Srijal97/Induction-Heating-ATmega128/README.md

# Induction-Heating-ATmega128
Code and other files for the control of Induction Heating of metals for temperatures up to 1200C+ for Riddhi Heatron. Control board uses the ATmega128 microcontroller.
