Srijal97/Induction-Heating-ATmega128/PCB/2018-SPIT-IH-Ver4-Atmeha-final1.brd

## EAGLE design PCB/2018-SPIT-IH-Ver4-Atmeha-final1.brd (2019-11-06)

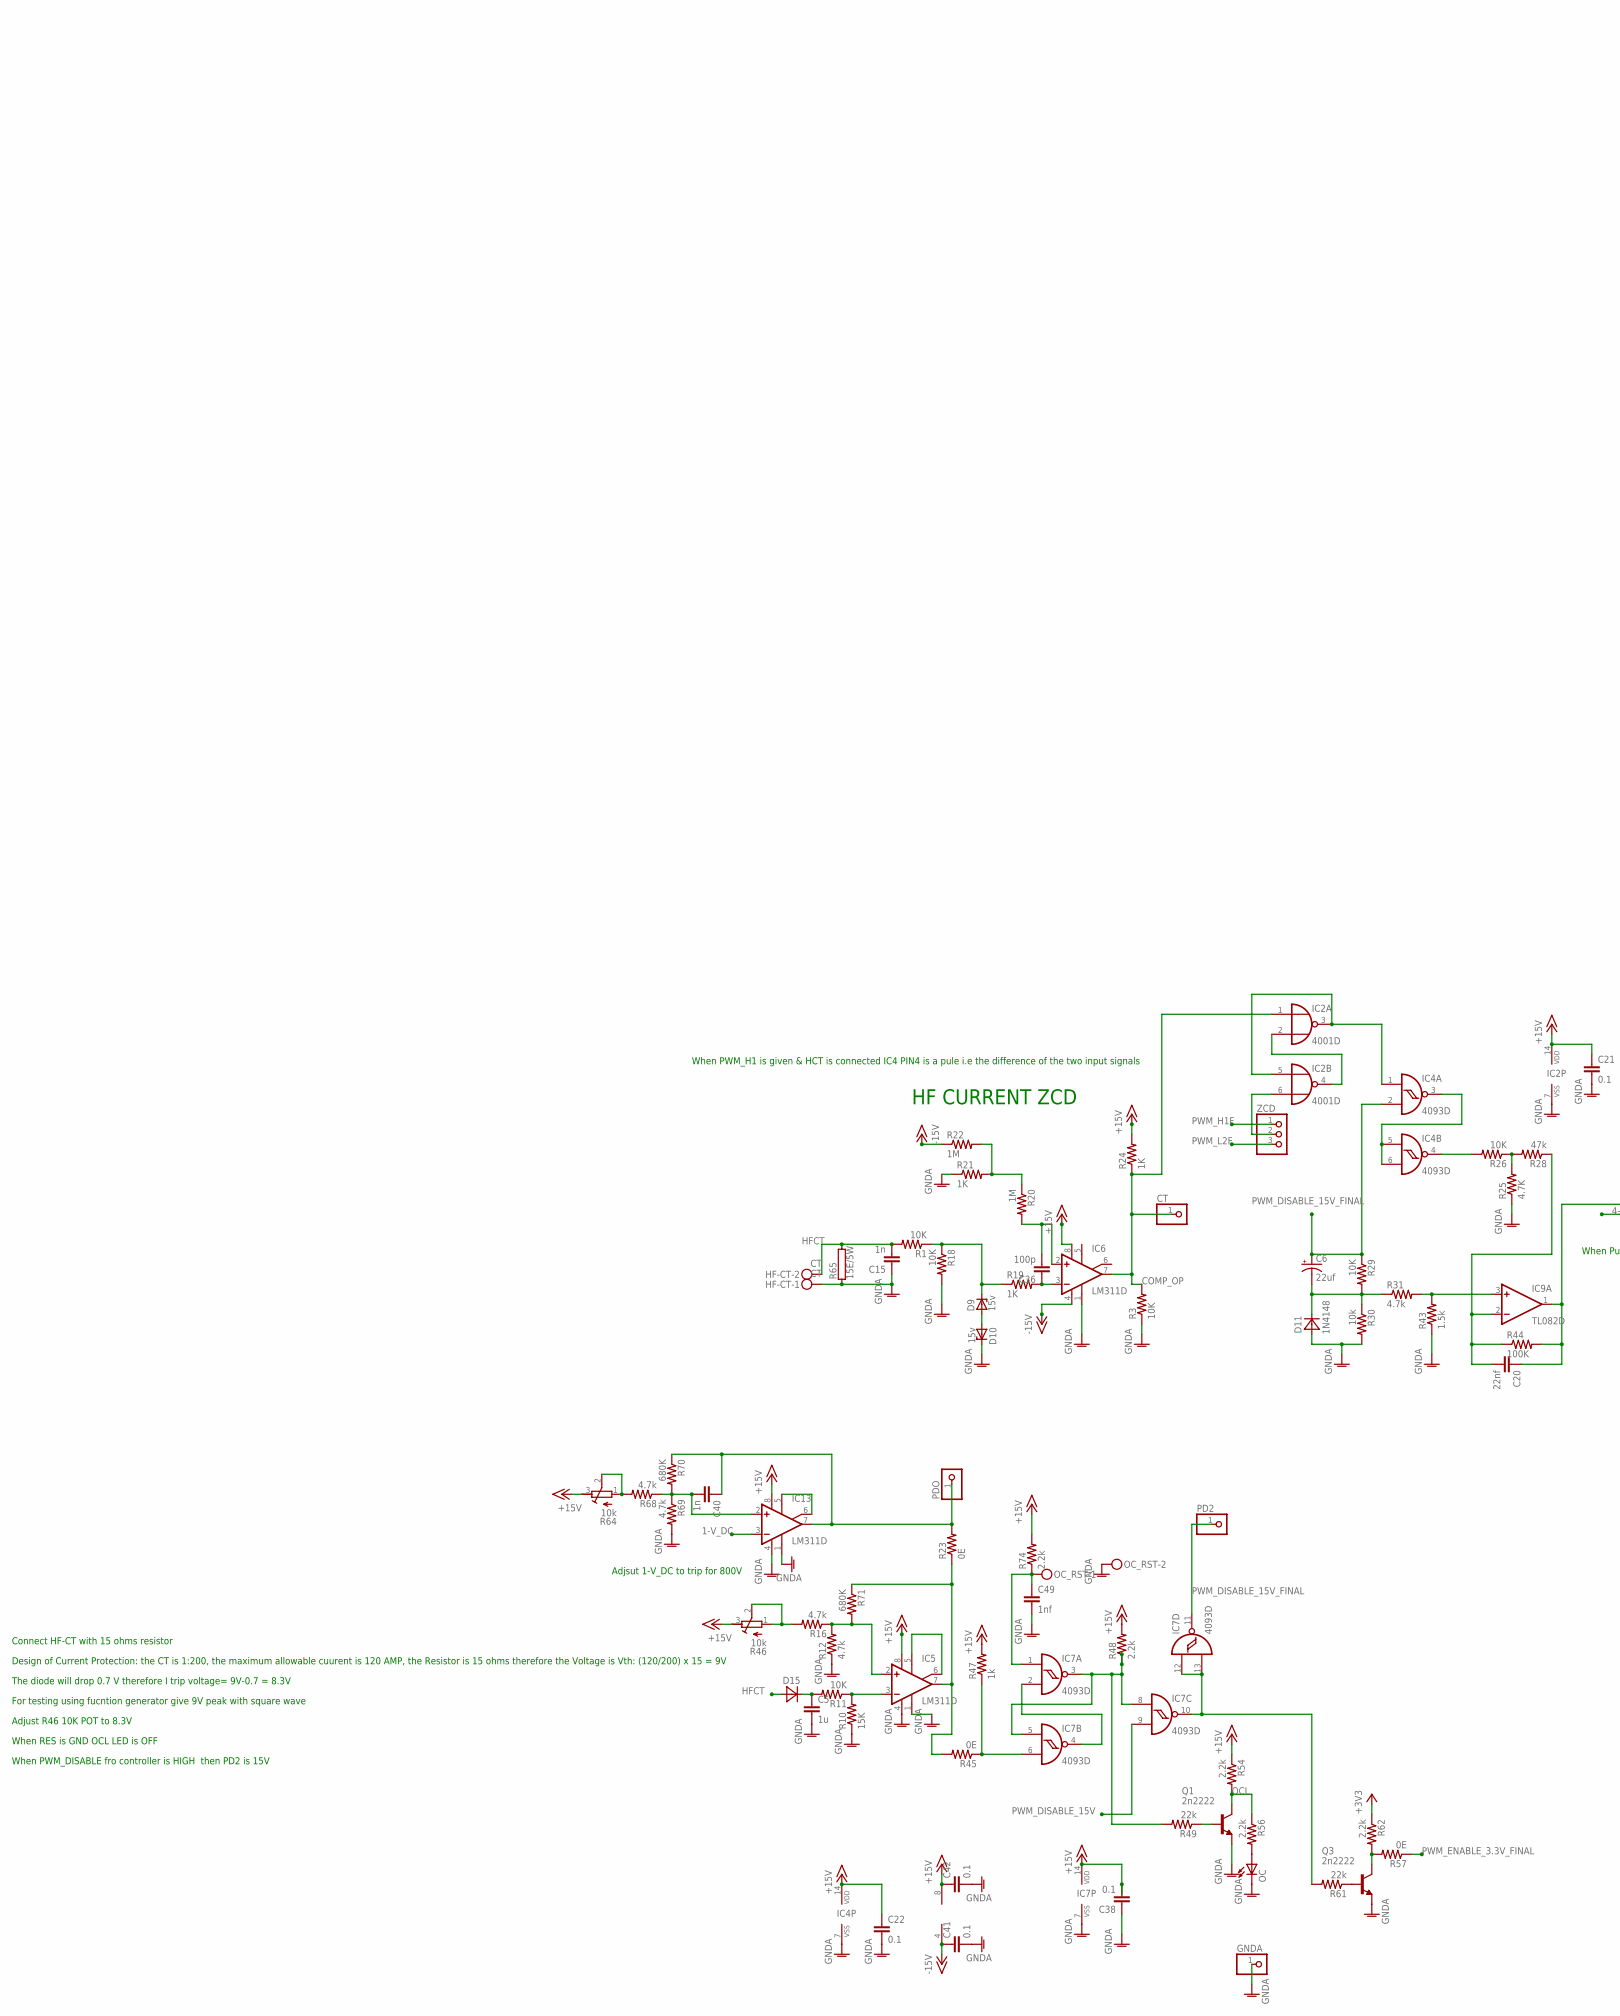
[picture p1: schematic 2018-SPIT-IH-Ver4-Atmeha-final1.sch, sheet 1, part in row 1, column 1]

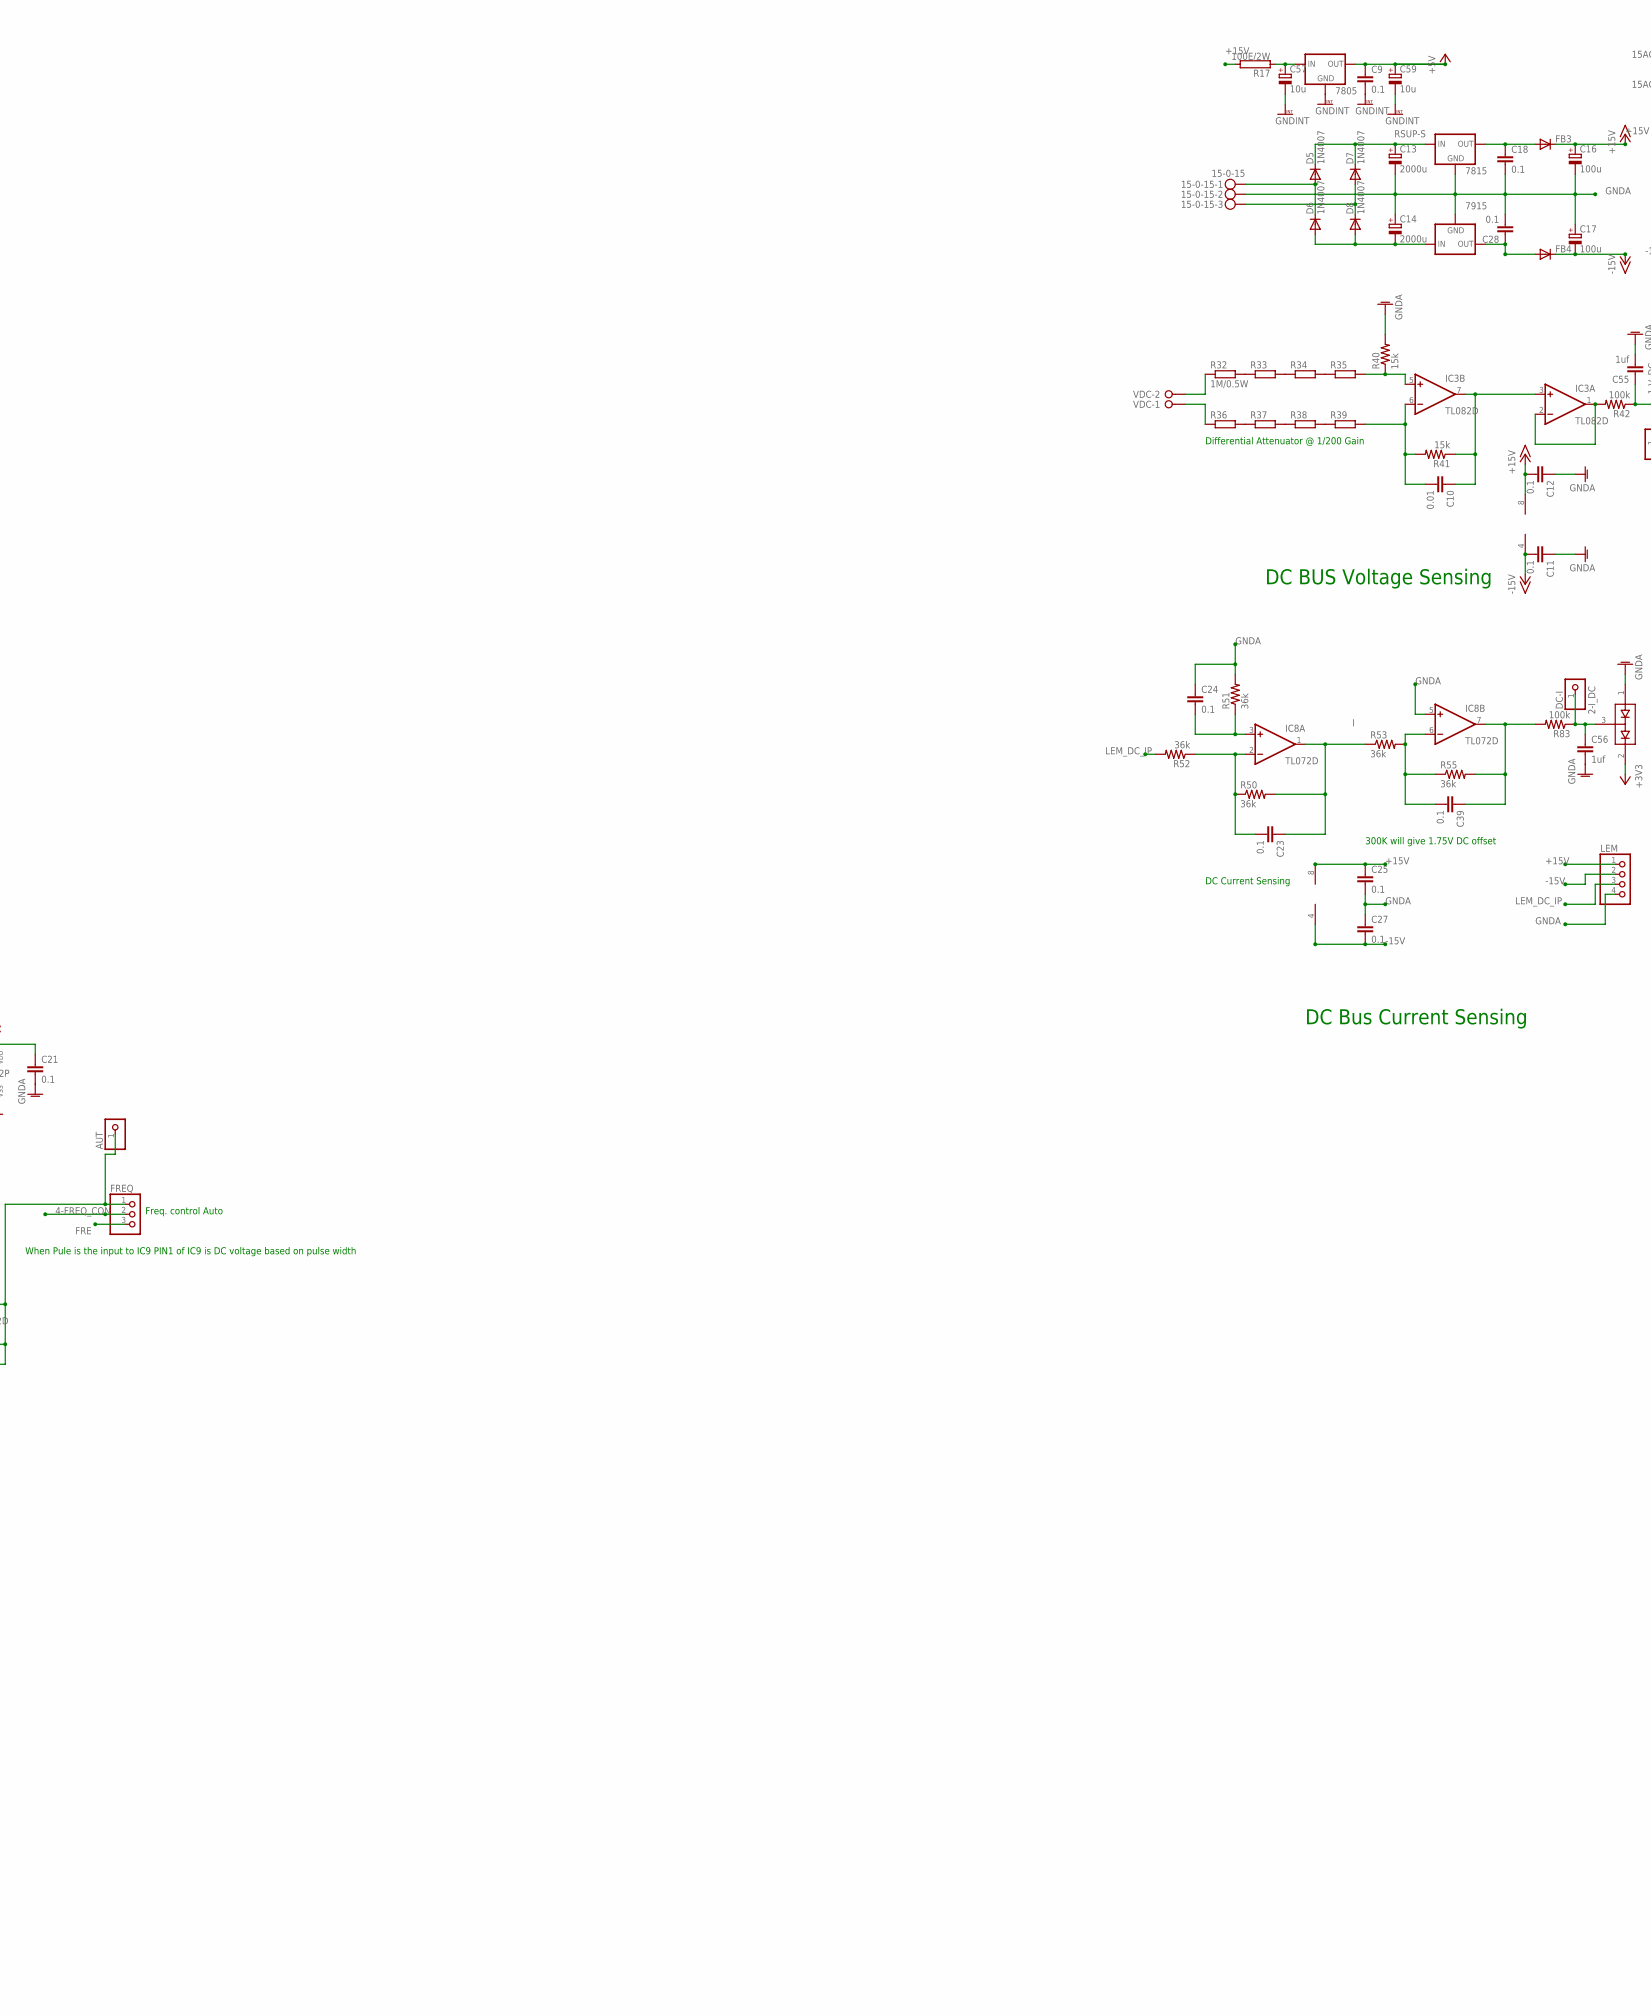
[picture p2: schematic 2018-SPIT-IH-Ver4-Atmeha-final1.sch, sheet 1, part in row 1, column 2]

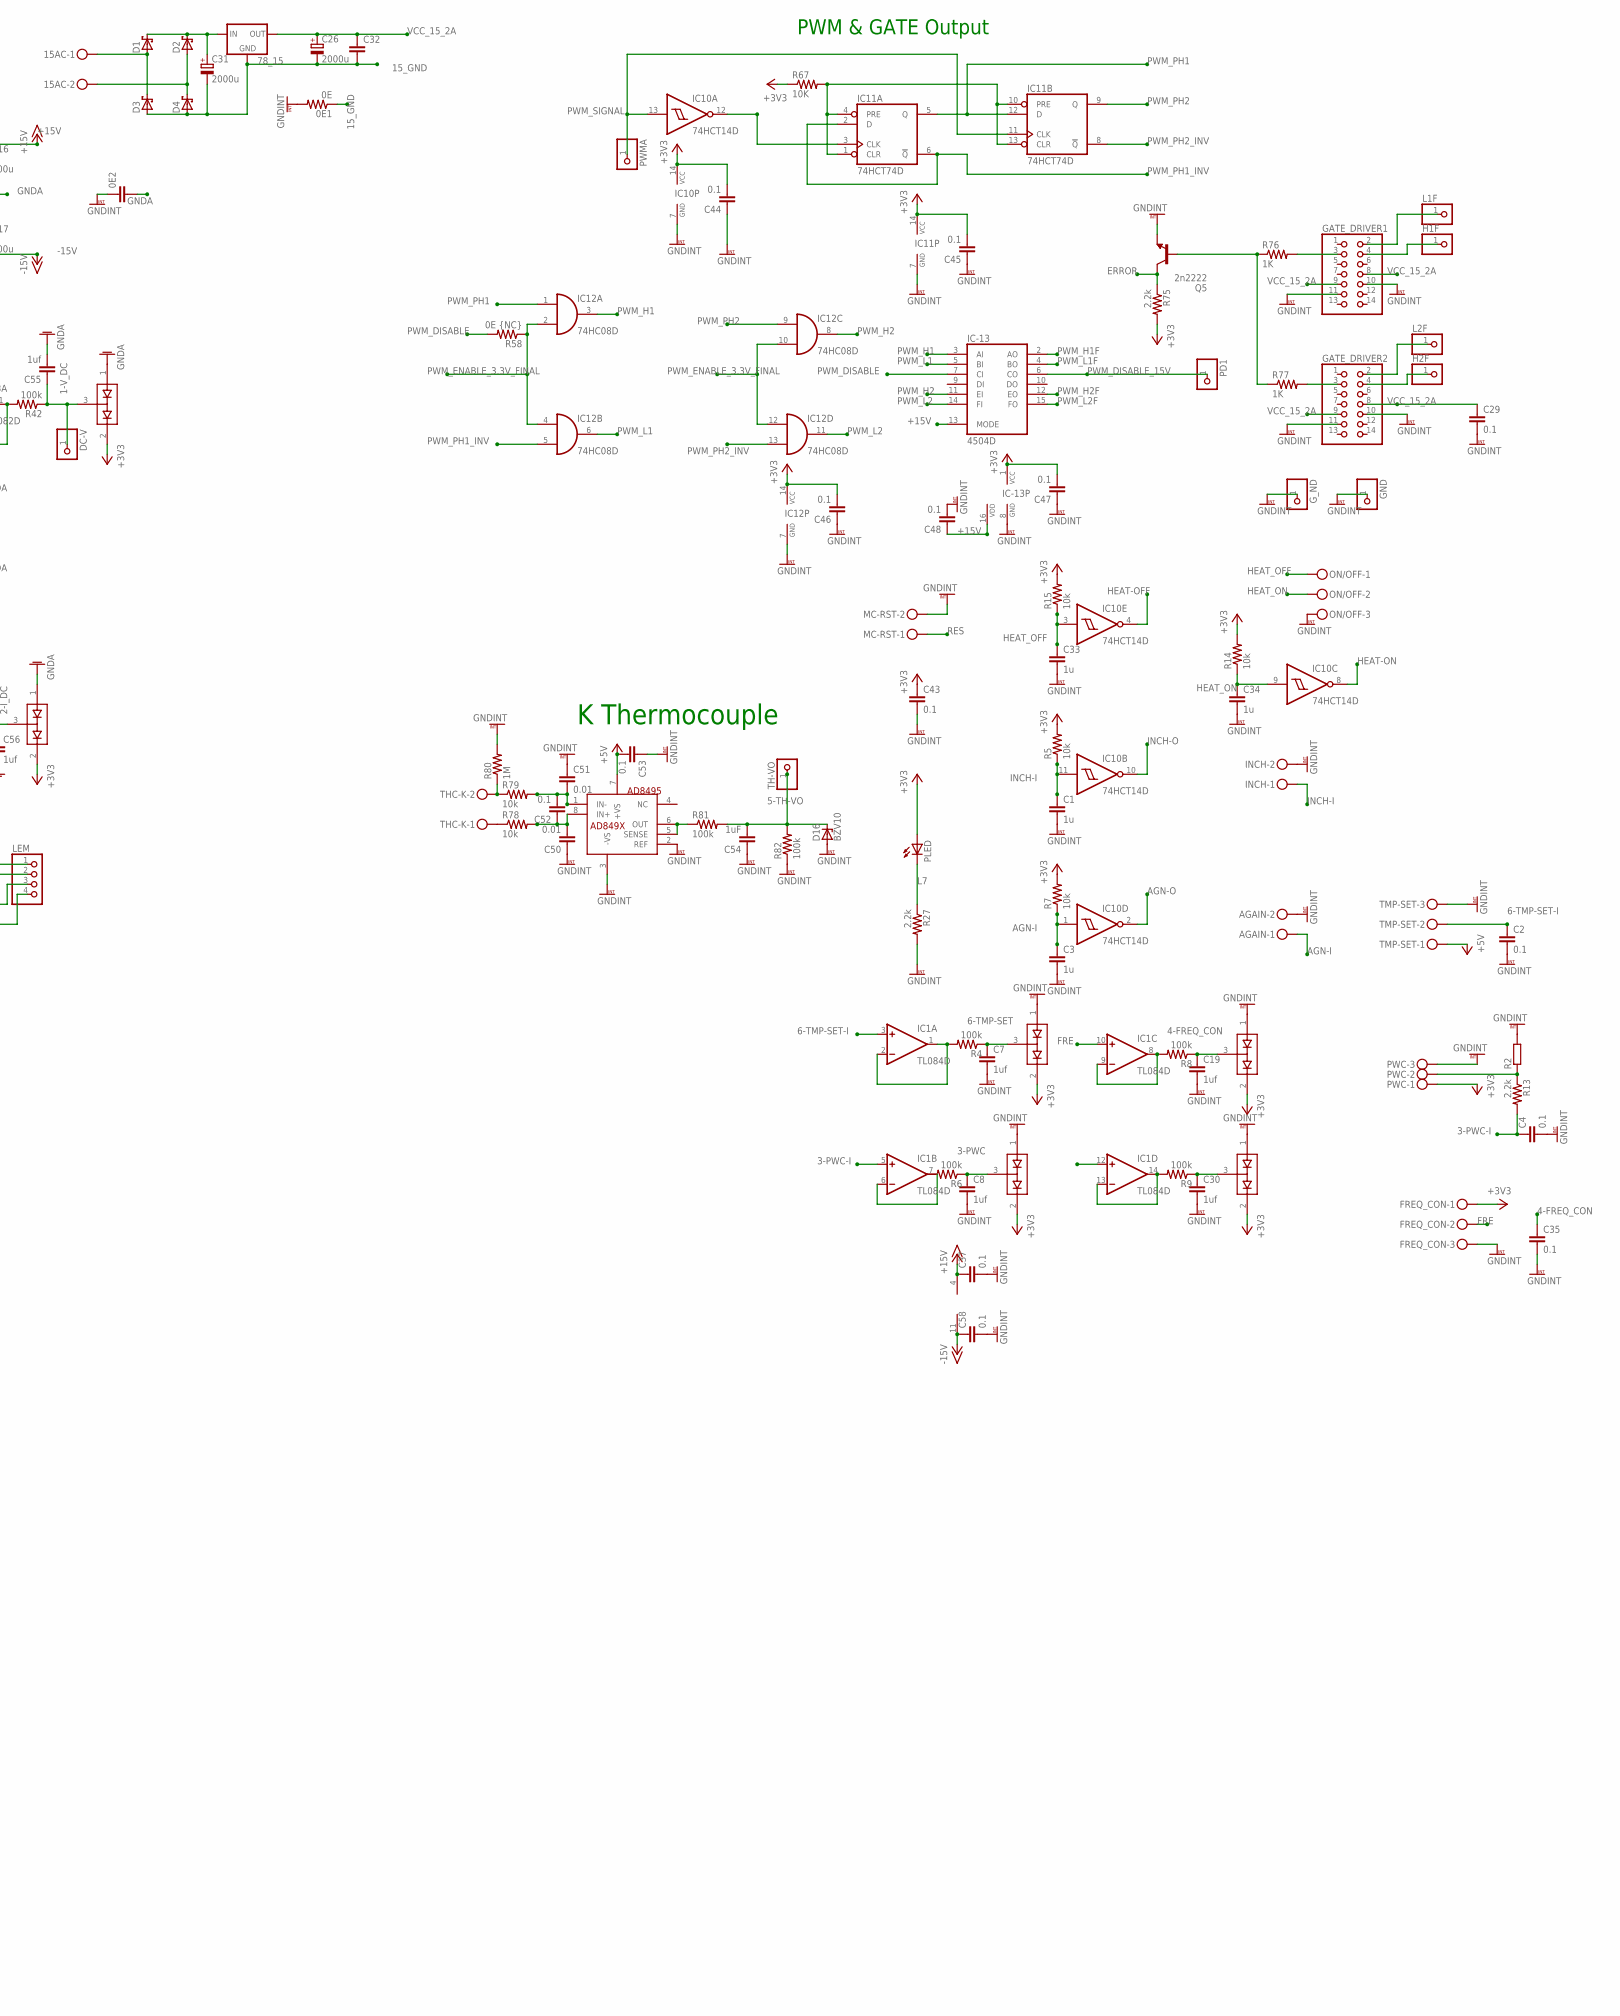
[picture p3: schematic 2018-SPIT-IH-Ver4-Atmeha-final1.sch, sheet 1, part in row 1, column 3]

Parts:
0E1: 0E; M1206
0E2: C1206
15-0-15: 15-0-15; MKDSN1,5/3-5,08
15AC: MKDSN1,5/2-5,08
78_15: 78XX-TO3; TO3-78
7805, 7815: 78XXS
7915: 79XXS
AD8495: AD849X; MSOP8
AGAIN: MKDSN1,5/2-5,08; MPN MKDSN 1,5/2-5.08
AUT: PINHD-1X1; 1X01
C1, C3, C5, C33, C34: 1u; C1206
C2, C4, C9, C11, C12, C18, C21, C22, C23, C24, C25, C27, C28, C29, C35, C37, C38, C39, C41, C42, C43, C44, C45, C46, C47, C48, C52, C53, C58: 0.1; C1206
C6: 22uf; E2,5-6
C7, C8, C19, C30, C55, C56: 1uf; C1206
C10, C50, C51: 0.01; C1206
C13, C14: 2000u; E5-13
C15, C40: 1n; C1206
C16, C17: 100u; E5-8,5
C20: 22nf; C1206
C26, C31: 2000u; E7,5-18
C32: C-EU025-025X050; C025-025X050
C36: 100p; C1206
C49: 1nf; C1206
C54: 1uF; C1206
C57, C59: 10u; R/2012-12R
CT: PINHD-1X1; 1X01
D1, D2, D3, D4: C4111-15
D5, D6, D7, D8: 1N4007; DO41-10
D9, D10: 15v; DO34Z7
D11: 1N4148; SMA
D12, D14, D17, D18, D19, D20: BAV99; SOT23
D15: SMA
D16: BZV10; DO34Z7
DC-I: PINHD-1X1; 1X01
DC-V: PINHD-1X1; 1X01
FB3, FB4: SOD57-10
FREQ: PINHD-1X3; 1X03
FREQ_CON: MKDSN1,5/3-5,08
GATE_DRIVER1, GATE_DRIVER2: PINHD-2X7; 2X07
GND: PINHD-1X1; 1X01
GNDA: PINHD-1X1; 1X01
G_ND: PINHD-1X1; 1X01
H1F, H2F: PINHD-1X1; 1X01
HF-CT: CT; MKDSN1,5/2-5,08
IC1: TL084D; SO14
IC2: 4001D; SO14
IC3, IC9: TL082D; SO08
IC4, IC7: 4093D; SO14
IC5, IC6, IC13: LM311D; SO08
IC8: TL072D; SO08
IC10: 74HCT14D; SO14
IC11: 74HCT74D; SO14
IC12: 74HC08D; SO14
IC-13: 4504D; SO16
INCH: MKDSN1,5/2-5,08; MPN MKDSN 1,5/2-5.08
L1F, L2F: PINHD-1X1; 1X01
LEM: PINHD-1X4; 1X04
MC-RST: MKDSN1,5/2-5,08
OC: LEDCHIPLED_1206; CHIPLED_1206
OC_RST: MKDSN1,5/2-5,08
ON/OFF: MKDSN1,5/3-5,08
PD1, PD2: PINHD-1X1; 1X01
PDO: PINHD-1X1; 1X01
PLED: LEDCHIPLED_1206; CHIPLED_1206
PWC: MKDSN1,5/3-5,08
PWMA: PINHD-1X1; 1X01
Q1, Q3, Q5: 2n2222; SOT23-BEC
R1, R3, R11, R18, R26, R29, R67: 10K; M1206
R2, R33, R34, R35, R36, R37, R38, R39: R-EU_0309/12; 0309/12
R4, R6, R8, R9, R42, R81, R82, R83: 100k; M1206
R5, R7, R14, R15, R30, R78, R79: 10k; M1206
R10: 15K; M1206
R12, R16, R31, R68, R69: 4.7k; M1206
R13, R27, R48, R54, R56, R62, R74, R75: 2.2k; M1206
R17: 100E/2W; CA5050
R19, R21, R24, R76, R77: 1K; M1206
R20, R22, R80: 1M; M1206
R23, R45, R57: 0E; M1206
R25: 4.7K; M1206
R28: 47k; M1206
R32: 1M/0.5W; 0309/12
R40, R41: 15k; M1206
R43: 1.5k; M1206
R44: 100K; M1206
R46, R64: 10k; RTRIM64W
R47: 1k; M1206
R49, R61: 22k; M1206
R50, R51, R52, R53, R55: 36k; M1206
R58: 0E {NC}; M1206
R65: 15E/5W; MPC71-5
R70, R71: 680K; M1206
TH-VO: PINHD-1X1; 1X01
THC-K: MKDSN1,5/2-5,08
TMP-SET: MKDSN1,5/3-5,08; MPN SMKDSN1,5/3-5,08
VDC: W237-2N
ZCD: PINHD-1X3; 1X03

Connections:
1-V_DC: C55.1, D12.3 (COM), DC-V.1, IC13.3 (-IN), R42.1; also elsewhere on the board
2: C39.1, IC8.7 (OUT), R55.2, R83.2
2-I_DC: C56.1, D14.3 (COM), DC-I.1, R83.1; also elsewhere on the board
3-PWC: C8.1, D18.3 (COM), R6.1; also elsewhere on the board
3-PWC-I: C4.1, IC1.5 (+IN), R13.2
4-FREQ_CON: C19.1, C35.1, D20.3 (COM), FREQ.2, R8.1; also elsewhere on the board
5-TH-VO: C54.2, D16.C, R81.2, R82.2, TH-VO.1; also elsewhere on the board
6-TMP-SET: C7.1, D17.3 (COM), R4.1; also elsewhere on the board
6-TMP-SET-I: C2.1, IC1.3 (+IN), TMP-SET.2
15_GND: 0E1.1, 78_15.3 (GND), C26.-, C31.-, C32.2, D3.A, D4.A
+5V: 7805.OUT, AD8495.7 (+VS), C9.1, C43.1, C44.2, C45.2, C46.2, C47.2, C53.2, C59.+, D12.2 (C2), D14.2 (C2), D17.2 (C2), D18.2 (C2), D19.2 (C2), D20.2 (C2), FREQ_CON.1, IC10.14 (VCC), IC11.14 (VCC), IC12.14 (VCC), IC-13.1 (VCC), PLED.A, PWC.1, R5.2, R7.2, R14.2, R15.2, R62.1, R67.1, R75.2, TMP-SET.1; also elsewhere on the board
+15V: C12.2, C16.+, C21.1, C22.1, C25.1, C37.1, C38.2, C42.1, C48.1, FB3.C, IC1.4 (V+), IC2.14 (VDD), IC3.8 (V+), IC4.14 (VDD), IC5.8 (V+), IC6.8 (V+), IC7.14 (VDD), IC8.8 (V+), IC9.8 (V+), IC13.8 (V+), IC-13.13 (MODE), IC-13.16 (VDD), LEM.1, R17.2, R24.2, R46.3 (A), R47.2, R48.2, R54.1, R64.3 (A), R74.2
-15V: C11.2, C17.-, C27.2, C41.1, C58.1, FB4.C, IC1.11 (V-), IC3.4 (V-), IC6.4 (V-), IC8.4 (V-), IC9.4 (V-), LEM.2, R22.1
AGN-I: AGAIN.1, C3.1, IC10.1 (I), R7.1
AGN-O: IC10.2 (O); also elsewhere on the board
COMP_OP: CT.1, IC2.1 (I0), IC6.7 (OUT), R3.2, R24.1
ERROR: Q5.C, R75.1; also elsewhere on the board
FRE: FREQ.3, FREQ_CON.2, IC1.10 (+IN)
GNDA: 0E2.2, 15-0-15.2, 7815.GND, 7915.GND, C5.2, C11.1, C12.1, C13.-, C14.+, C15.1, C16.-, C17.+, C18.2, C21.2, C22.2, C24.1, C25.2, C27.1, C28.2, C38.1, C41.2, C42.2, C49.2, C55.2, C56.2, D10.C, D11.A, D12.1 (A1), D14.1 (A1), GNDA.1, HF-CT.1, IC2.7 (VSS), IC4.7 (VSS), IC5.1 (GND), IC5.4 (V-), IC6.1 (GND), IC7.7 (VSS), IC8.5 (+IN), IC13.1 (GND), IC13.4 (V-), LEM.4, OC.C, OC_RST.2, Q1.E, Q3.E, R3.1, R10.1, R12.1, R18.2, R21.1, R25.1, R30.2, R40.2, R43.1, R51.2, R65.1, R69.2
GNDINT: 0E1.2, 0E2.1, 7805.GND, AD8495.2 (REF), AD8495.3 (-VS), AGAIN.2, C1.2, C2.2, C3.2, C4.2, C7.2, C8.2, C9.2, C19.2, C29.2, C30.2, C33.2, C34.2, C35.2, C37.2, C43.2, C44.1, C45.1, C46.1, C47.1, C48.2, C50.1, C51.1, C53.1, C54.1, C57.-, C58.2, C59.-, D16.A, D17.1 (A1), D18.1 (A1), D19.1 (A1), D20.1 (A1), FREQ_CON.3, GATE_DRIVER1.10, GATE_DRIVER1.11, GATE_DRIVER2.10, GATE_DRIVER2.11, GND.1, G_ND.1, IC10.7 (GND), IC11.7 (GND), IC12.7 (GND), IC-13.8 (GND), INCH.2, MC-RST.2, ON/OFF.3, PWC.3, Q5.E, R2.2, R27.2, R80.2, R82.1, TMP-SET.3; also elsewhere on the board
HEAT-OFF: IC10.4 (O); also elsewhere on the board
HEAT-ON: IC10.8 (O); also elsewhere on the board
HEAT_OFF: C33.1, IC10.3 (I), ON/OFF.1, R15.1
HEAT_ON: C34.1, IC10.9 (I), ON/OFF.2, R14.1
HFCT: C15.2, D15.A, HF-CT.2, R1.2, R65.2
I: C23.1, IC8.1 (OUT), R50.2, R53.1
INCH-I: C1.1, IC10.11 (I), INCH.1, R5.1
INCH-O: IC10.10 (O); also elsewhere on the board
L7: PLED.C, R27.1
LEM_DC_IP: LEM.3, R52.2
unnamed: IC1.1 (OUT), IC1.2 (-IN), R4.2
unnamed: IC4.3 (O), IC4.5 (I0), IC4.6 (I1)
unnamed: IC1.6 (-IN), IC1.7 (OUT)
unnamed: IC1.8 (OUT), IC1.9 (-IN), R8.2
unnamed: C49.1, IC7.1 (I0), OC_RST.1, R74.1
unnamed: IC1.13 (-IN), IC1.14 (OUT), R9.2
unnamed: IC2.2 (I1), IC2.4 (O)
unnamed: IC4.4 (O), R26.2
unnamed: AUT.1, C20.1, FREQ.1, IC9.1 (OUT), R44.2
unnamed: 15-0-15.1, D5.A, D6.C
unnamed: AD8495.8 (IN+), C50.2, C52.1, R78.2
unnamed: IC5.2 (+IN), R12.2, R16.1, R71.2
unnamed: IC2.3 (O), IC2.5 (I0), IC4.1 (I0)
unnamed: IC10.12 (O), IC11.3 (CLK)
unnamed: IC5.5 (ON), IC5.6 (ON/STR)
unnamed: IC5.3 (-IN), R10.2, R11.1
unnamed: PWC.2, R2.1, R13.1
unnamed: IC11.1 (CLR), IC11.4 (PRE), IC11.10 (PRE), IC11.13 (CLR), R67.2
unnamed: GATE_DRIVER1.3, R76.2
unnamed: IC5.7 (OUT), R23.1, R45.2, R71.1
unnamed: IC7.6 (I1), R45.1, R47.1
unnamed: C5.1, D15.C, R11.2
unnamed: R32.2, R33.1
unnamed: R33.2, R34.1
unnamed: R34.2, R35.1
unnamed: R36.2, R37.1
unnamed: 15-0-15.3, D7.A, D8.C
unnamed: 7915.IN, C14.-, D6.A, D8.A
unnamed: D9.C, R1.1, R18.1, R19.1
unnamed: 7805.IN, C57.+, R17.1
unnamed: 7815.OUT, C18.1, FB3.A
unnamed: R37.2, R38.1
unnamed: 7915.OUT, C28.1, FB4.A
unnamed: D9.A, D10.A
unnamed: R38.2, R39.1
unnamed: C36.1, IC6.3 (-IN), R19.2
unnamed: C36.2, IC6.2 (+IN), R20.2
unnamed: R20.1, R21.2, R22.2
unnamed: R16.2, R46.1 (E), R46.2 (S)
unnamed: R32.1, VDC.2
unnamed: Q1.B, R49.1
unnamed: R36.1, VDC.1
unnamed: IC3.5 (+IN), R35.2, R40.1
unnamed: IC7.3 (O), IC7.5 (I0), IC7.8 (I0), R48.1, R49.2
unnamed: IC7.2 (I1), IC7.4 (O)
unnamed: C10.2, IC3.6 (-IN), R39.2, R41.2
unnamed: C10.1, IC3.3 (+IN), IC3.7 (OUT), R41.1
unnamed: R25.2, R26.1, R28.2
unnamed: IC3.1 (OUT), IC3.2 (-IN), R42.2
unnamed: AD8495.1 (IN-), C51.2, C52.2, R79.2
unnamed: IC7.10 (O), IC7.12 (I0), IC7.13 (I1), R61.2
unnamed: C6.-, D11.C, R29.2, R30.1, R31.1
unnamed: OC.A, R56.2
unnamed: IC2.6 (I1), ZCD.2
unnamed: IC9.3 (+IN), R31.2, R43.2
unnamed: GATE_DRIVER2.3, R77.2
unnamed: C20.2, IC9.2 (-IN), R28.1, R44.1
unnamed: Q3.B, R61.1
unnamed: C23.2, IC8.2 (-IN), R50.1, R52.1
unnamed: C24.2, IC8.3 (+IN), R51.1
unnamed: R78.1, THC-K.1
unnamed: C39.2, IC8.6 (-IN), R53.2, R55.1
unnamed: Q3.C, R57.2, R62.2
unnamed: IC13.5 (ON), IC13.6 (ON/STR)
unnamed: Q5.B, R76.1, R77.1
unnamed: R79.1, R80.1, THC-K.2
unnamed: R64.1 (E), R64.2 (S), R68.2
unnamed: C40.2, IC13.2 (+IN), R68.1, R69.1, R70.2
unnamed: C40.1, IC13.7 (OUT), PDO.1, R23.2, R70.1
unnamed: AD8495.5 (SENSE), AD8495.6 (OUT), R81.1
unnamed: C30.1, D19.3 (COM), R9.1
unnamed: 15AC.1, D1.A, D3.C
unnamed: 15AC.2, D2.A, D4.C
unnamed: 78_15.2 (IN), C31.+, D1.C, D2.C
OCL: Q1.C, R54.2, R56.1
PWM_DISABLE: IC-13.7 (CI), R58.2; also elsewhere on the board
PWM_DISABLE_15V: IC7.9 (I1), IC-13.6 (CO), PD1.1
PWM_DISABLE_15V_FINAL: C6.+, IC4.2 (I1), IC7.11 (O), PD2.1, R29.1
PWM_ENABLE_3.3V_FINAL: IC12.2 (I1), IC12.4 (I0), IC12.10 (I1), IC12.12 (I0), R57.1, R58.1; also elsewhere on the board
PWM_H1: IC12.3 (O), IC-13.3 (AI)
PWM_H1F: GATE_DRIVER1.4, H1F.1, IC-13.2 (AO), ZCD.1
PWM_H2: IC12.8 (O), IC-13.11 (EI)
PWM_H2F: GATE_DRIVER2.4, H2F.1, IC-13.12 (EO)
PWM_L1: IC12.6 (O), IC-13.5 (BI)
PWM_L1F: GATE_DRIVER1.2, IC-13.4 (BO), L1F.1
PWM_L2: IC12.11 (O), IC-13.14 (FI)
PWM_L2F: GATE_DRIVER2.2, IC-13.15 (FO), L2F.1, ZCD.3
PWM_PH1: IC11.5 (Q), IC11.12 (D), IC12.1 (I0)
PWM_PH1_INV: IC11.2 (D), IC11.6 (!Q), IC12.5 (I1)
PWM_PH2: IC11.9 (Q), IC12.9 (I0)
PWM_PH2_INV: IC11.8 (!Q), IC12.13 (I1)
PWM_SIGNAL: IC10.13 (I), IC11.11 (CLK), PWMA.1; also elsewhere on the board
RES: MC-RST.1; also elsewhere on the board
RSUP-S: 7815.IN, C13.+, D5.C, D7.C
VCC_15_2A: 78_15.1 (OUT), C26.+, C29.1, C32.1, GATE_DRIVER1.8, GATE_DRIVER1.9, GATE_DRIVER2.8, GATE_DRIVER2.9

Notes on the sheet:
300K will give 1.75V DC offset
Differential Attenuator @ 1/200 Gain
DC Current Sensing
HF CURRENT ZCD
Freq. control Auto
PWM & GATE Output
DC BUS Voltage Sensing
DC Bus Current Sensing
When RES is GND OCL LED is OFF
When PWM_DISABLE fro controller is HIGH then PD2 is 15V
When PWM_H1 is given & HCT is connected IC4 PIN4 is a pule i.e the difference of the two input signals
When Pule is the input to IC9 PIN1 of IC9 is DC voltage based on pulse width
K Thermocouple
Design of Current Protection: the CT is 1:200, the maximum allowable cuurent is 120 AMP, the Resistor is 15 ohms therefore the Voltage is Vth: (120/200) x 15 = 9V
The diode will drop 0.7 V therefore I trip voltage= 9V-0.7 = 8.3V
For testing using fucntion generator give 9V peak with square wave
Adjust R46 10K POT to 8.3V
Adjsut 1-V_DC to trip for 800V
Connect HF-CT with 15 ohms resistor

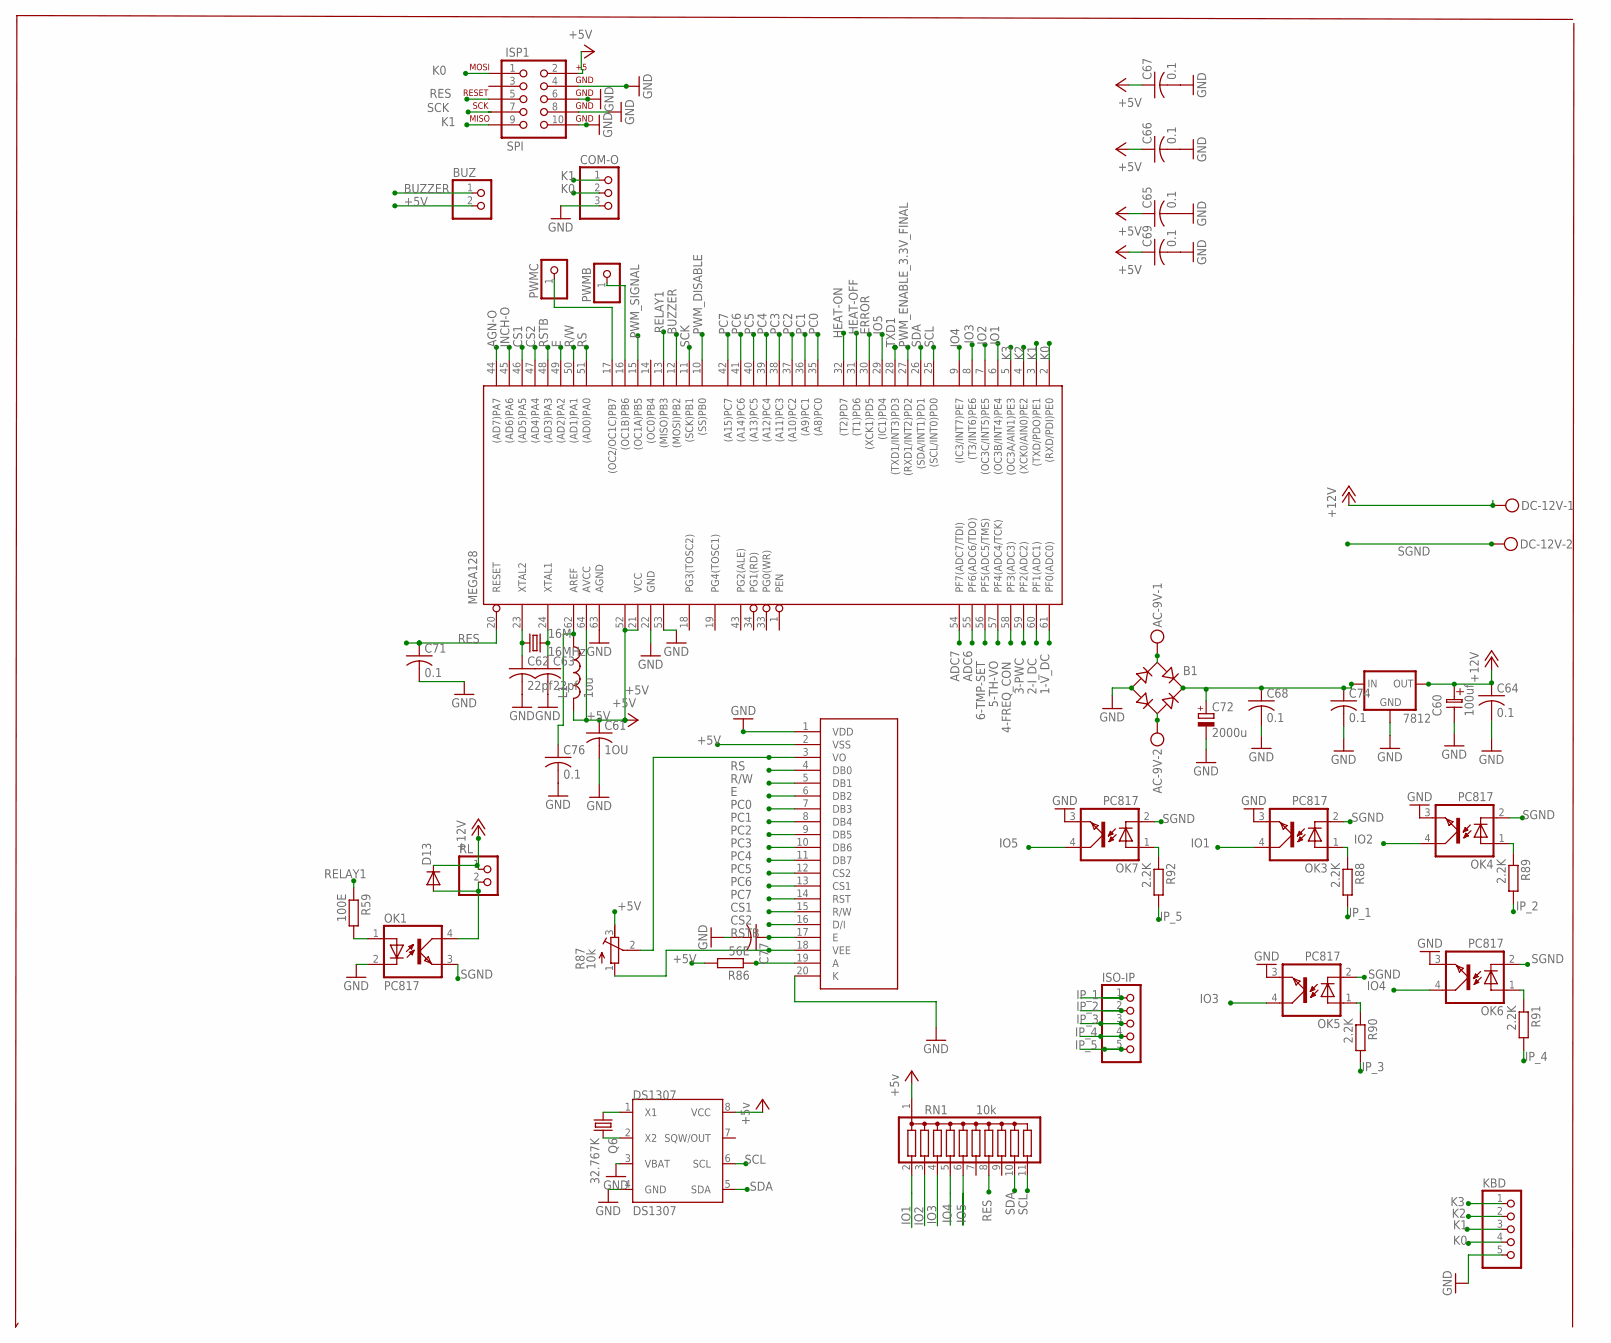
[picture p4: schematic 2018-SPIT-IH-Ver4-Atmeha-final1.sch, sheet 2]

Parts:
16M: 16MHz; HC49/S
7812: 78XXS
AC-9V: MKDSN1,5/2-5,08
B1: RB1A
BUZ: PINHD-1X2; 1X02
C60: 100uf; ES-2,5
C61: 1OU; C1206
C62, C63: 22pf; C1206
C64, C65, C66, C67, C68, C69, C71, C74, C76: 0.1; C1206
C72: 2000u; E5-10,5
C77: C-USC1206; C1206
COM-O: PINHD-1X3; 1X03
D13: DO41-10
DC-12V: MKDSN1,5/2-5,08
DS1307: DS1307; SOIC-8
GLCD: LCD-G12864BARE; 1X20
ISO-IP: PINHD-1X5; 1X05
ISP1: SPI; 2X5-SHROUDED_LOCK
KBD: PINHD-1X5; 1X05
L1: 1ou; 0207/10
MEGA128: TQFP64
OK1, OK3, OK4, OK5, OK6, OK7: PC817; DIL04; MPN PC817X4J000F
PWMB: PINHD-1X1; 1X01
PWMC: PINHD-1X1; 1X01
Q6: 32.767K; TC26H
R59: 100E; M1206
R86: 56E; M1206
R87: 10k; RTRIM64W
R88, R89, R90, R91, R92: 2.2K; M1206
RL: PINHD-1X2; 1X02
RN1: 10k; SIL11

Connections:
1-V_DC: MEGA128.61 (PF0(ADC0)); also elsewhere on the board
2-I_DC: MEGA128.60 (PF1(ADC1)); also elsewhere on the board
3-PWC: MEGA128.59 (PF2(ADC2)); also elsewhere on the board
4-FREQ_CON: MEGA128.58 (PF3(ADC3)); also elsewhere on the board
5-TH-VO: MEGA128.57 (PF4(ADC4/TCK)); also elsewhere on the board
6-TMP-SET: MEGA128.56 (PF5(ADC5/TMS)); also elsewhere on the board
+5V: BUZ.2, C61.1, C65.1, C66.1, C67.1, C69.1, DS1307.8 (VCC), GLCD.2 (VSS), ISP1.2, L1.2, MEGA128.21 (VCC), MEGA128.52 (VCC1), MEGA128.64 (AVCC), R86.2, R87.3 (A), RN1.1; also elsewhere on the board
+12V: 7812.OUT, C60.1, C64.1, D13.C, DC-12V.1, RL.1
ADC6: MEGA128.55 (PF6(ADC6/TDO))
ADC7: MEGA128.54 (PF7(ADC7/TDI))
AGN-O: MEGA128.44 ((AD7)PA7); also elsewhere on the board
BUZZER: BUZ.1, MEGA128.12 ((MOSI)PB2)
CS1: GLCD.15 (R/W), MEGA128.46 ((AD5)PA5)
CS2: GLCD.16 (D/I), MEGA128.47 ((AD4)PA4)
E: GLCD.6 (DB2), MEGA128.49 ((AD2)PA2)
ERROR: MEGA128.30 ((XCK1)PD5); also elsewhere on the board
GNDINT: C61.2, C62.2, C63.2, C65.2, C66.2, C67.2, C69.2, C71.2, C76.2, C77.2, COM-O.3, DS1307.3 (VBAT), DS1307.4 (GND), GLCD.1 (VDD), GLCD.20 (K), ISP1.4, ISP1.6, ISP1.8, ISP1.10, KBD.5, MEGA128.22 (GND), MEGA128.53 (GND1), MEGA128.63 (AGND), OK1.2 (C), OK3.3 (EMIT), OK4.3 (EMIT), OK5.3 (EMIT), OK6.3 (EMIT), OK7.3 (EMIT); also elsewhere on the board
HEAT-OFF: MEGA128.31 ((T1)PD6); also elsewhere on the board
HEAT-ON: MEGA128.32 ((T2)PD7); also elsewhere on the board
INCH-O: MEGA128.45 ((AD6)PA6); also elsewhere on the board
IO1: MEGA128.6 ((OC3B/INT4)PE4), OK3.4 (COL), RN1.2
IO2: MEGA128.7 ((OC3C/INT5)PE5), OK4.4 (COL), RN1.3
IO3: MEGA128.8 ((T3/INT6)PE6), OK5.4 (COL), RN1.4
IO4: MEGA128.9 ((IC3/INT7)PE7), OK6.4 (COL), RN1.5
IO5: MEGA128.29 ((IC1)PD4), OK7.4 (COL), RN1.6
IP_1: ISO-IP.1, R88.2
IP_2: ISO-IP.2, R89.2
IP_3: ISO-IP.3, R90.2
IP_4: ISO-IP.4, R91.2
IP_5: ISO-IP.5, R92.2
K0: COM-O.2, ISP1.1, KBD.4, MEGA128.2 ((RXD/PDI)PE0)
K1: COM-O.1, ISP1.9, KBD.3, MEGA128.3 ((TXD/PDO)PE1)
K2: KBD.2, MEGA128.4 ((XCK0/AIN0)PE2)
K3: KBD.1, MEGA128.5 ((OC3A/AIN1)PE3)
unnamed: OK1.1 (A), R59.2
unnamed: D13.A, OK1.4 (COL), RL.2
unnamed: MEGA128.16 ((OC1B)PB6), PWMB.1
unnamed: MEGA128.17 ((OC2/OC1C)PB7), PWMC.1
unnamed: 16M.1, C62.1, MEGA128.23 (XTAL2)
unnamed: 16M.2, C63.1, MEGA128.24 (XTAL1)
unnamed: GLCD.3 (VO), R87.2 (S)
unnamed: GLCD.18 (VEE), R87.1 (E)
unnamed: GLCD.19 (A), R86.1
unnamed: OK3.1 (A), R88.1
unnamed: OK4.1 (A), R89.1
unnamed: OK5.1 (A), R90.1
unnamed: OK6.1 (A), R91.1
unnamed: OK7.1 (A), R92.1
unnamed: DS1307.2 (X2), Q6.2
unnamed: DS1307.1 (X1), Q6.1
unnamed: AC-9V.1, B1.AC1
unnamed: AC-9V.2, B1.AC2
unnamed: C76.1, L1.1, MEGA128.62 (AREF)
unnamed: 7812.IN, B1.+, C68.1, C72.+, C74.1
PC0: GLCD.7 (DB3), MEGA128.35 ((A8)PC0)
PC1: GLCD.8 (DB4), MEGA128.36 ((A9)PC1)
PC2: GLCD.9 (DB5), MEGA128.37 ((A10)PC2)
PC3: GLCD.10 (DB6), MEGA128.38 ((A11)PC3)
PC4: GLCD.11 (DB7), MEGA128.39 ((A12)PC4)
PC5: GLCD.12 (CS2), MEGA128.40 ((A13)PC5)
PC6: GLCD.13 (CS1), MEGA128.41 ((A14)PC6)
PC7: GLCD.14 (RST), MEGA128.42 ((A15)PC7)
PWM_DISABLE: MEGA128.10 ((SS)PB0); also elsewhere on the board
PWM_ENABLE_3.3V_FINAL: MEGA128.27 ((RXD1/INT2)PD2); also elsewhere on the board
PWM_SIGNAL: MEGA128.15 ((OC1A)PB5); also elsewhere on the board
R/W: GLCD.5 (DB1), MEGA128.50 ((AD1)PA1)
RELAY1: MEGA128.13 ((MISO)PB3), R59.1
RES: C71.1, ISP1.5, MEGA128.20 (RESET), RN1.8; also elsewhere on the board
RS: GLCD.4 (DB0), MEGA128.51 ((AD0)PA0)
RSTB: C77.1, GLCD.17 (E), MEGA128.48 ((AD3)PA3)
SCK: ISP1.7, MEGA128.11 ((SCK)PB1)
SCL: DS1307.6 (SCL), MEGA128.25 ((SCL/INT0)PD0), RN1.11
SDA: DS1307.5 (SDA), MEGA128.26 ((SDA/INT1)PD1), RN1.10
SGND: 7812.GND, B1.-, C60.2, C64.2, C68.2, C72.-, C74.2, DC-12V.2, OK1.3 (EMIT), OK3.2 (C), OK4.2 (C), OK5.2 (C), OK6.2 (C), OK7.2 (C)
TXD1: MEGA128.28 ((TXD1/INT3)PD3)
