Srijal97/Induction-Heating-ATmega128/PCB/2018-SPIT-IH-Ver4-Atmeha-final1.brd

## EAGLE design PCB/2018-SPIT-IH-Ver4-Atmeha-final1.brd (continued)

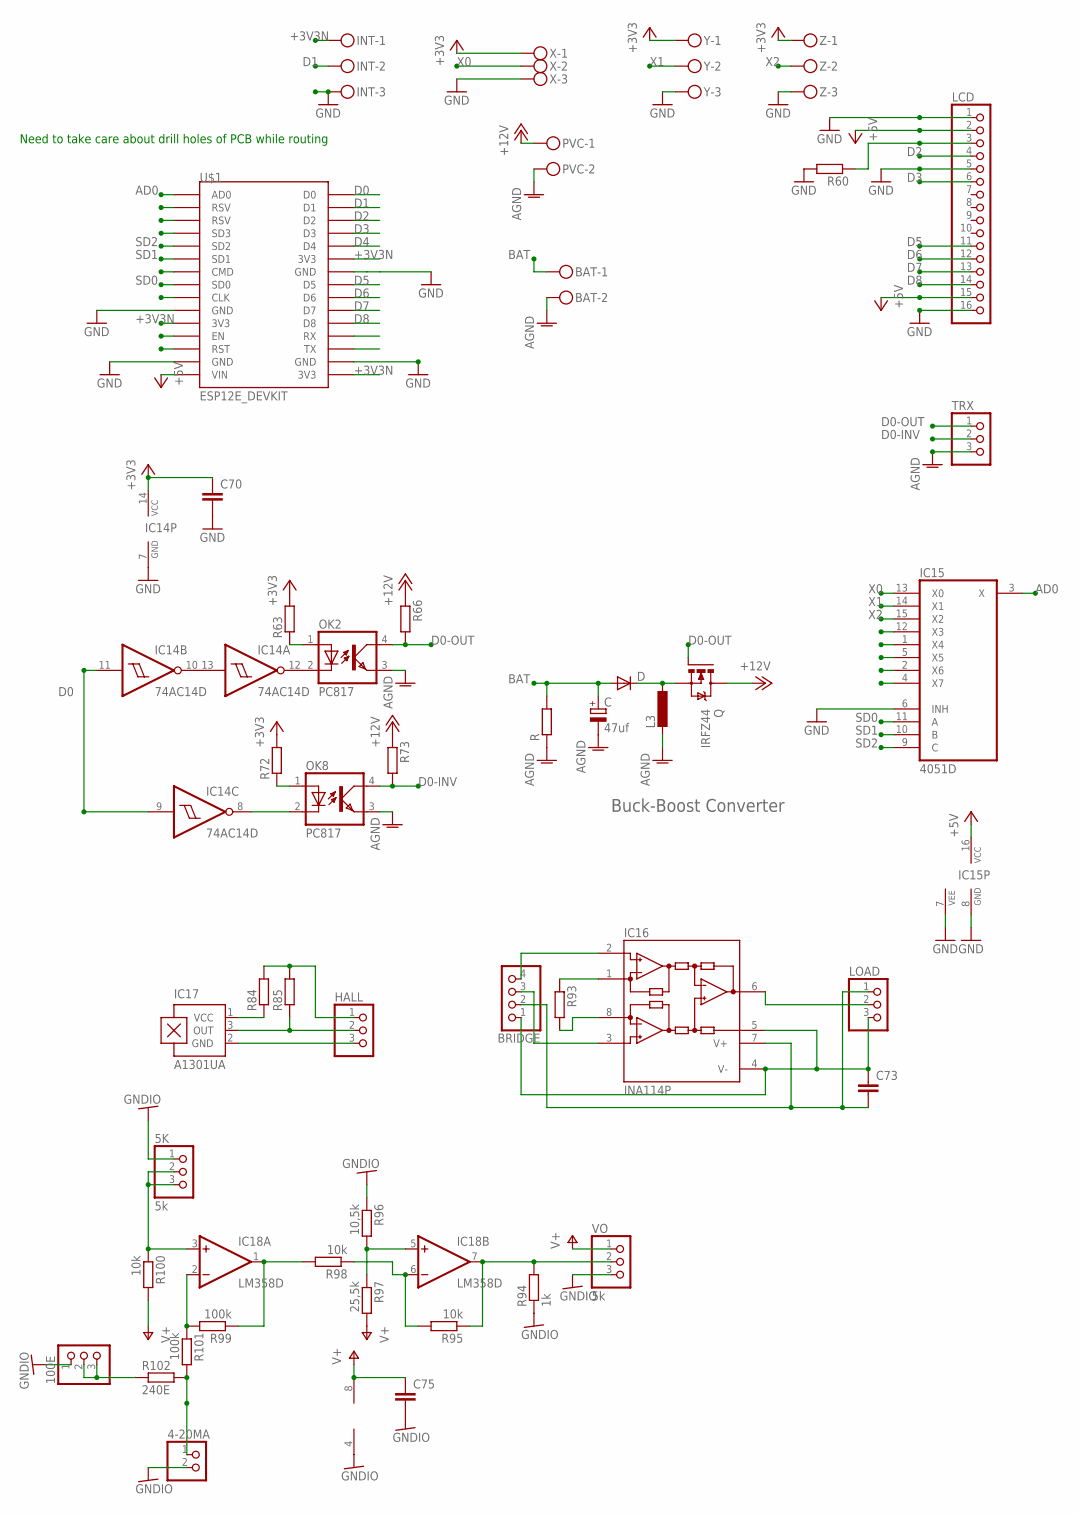
[picture p5: schematic 2018-SPIT-IH-Ver4-Atmeha-final1.sch, sheet 3]

Parts:
4-20MA: PINHD-1X2; 1X02
5K: 5k; 1X03
100E: 1X03
BAT: MKDSN1,5/2-5,08; MPN MKDSN 1,5/2-5.08
BRIDGE: PINHD-1X4; 1X04
C: 47uf; B45181A
C70, C73, C75: C-EUC1206; C1206
D: DO41-10
HALL: PINHD-1X3; 1X03
IC14: 74AC14D; SO14
IC15: 4051D; SO16
IC16: INA114P; DIL08
IC17: A1301UA; SIP3-UA
IC18: LM358D; SO08
INT: MKDSN1,5/3-5,08; MPN SMKDSN1,5/3-5,08
L3: L-EU0207/12; 0207/12
LCD: PINHD-1X16; 1X16
LOAD: PINHD-1X3; 1X03
OK2, OK8: PC817; DIL04; MPN PC817X4J000F
PVC: MKDSN1,5/2-5,08
Q: IRFZ44; TO220BV
R: R-EU_0207/10; 0207/10
R60, R63, R66, R72, R73, R84, R85, R93: R-EU_M1206; M1206
R94: 1k; M1206
R95, R98, R100: 10k; M1206
R96: 10,5k; M1206
R97: 25,5k; M1206
R99, R101: 100k; M1206
R102: 240E; M1206
TRX: PINHD-1X3; 1X03
U$1: ESP12E_DEVKIT
VO: 5k; 1X03
X: MKDSN1,5/3-5,08
Y: MKDSN1,5/3-5,08; MPN SMKDSN1,5/3-5,08
Z: MKDSN1,5/3-5,08; MPN SMKDSN1,5/3-5,08

Connections:
+3V3N: C70.1, IC14.14 (VCC), INT.1, R63.2, R72.2, U$1.3V3@0 (3V3), U$1.3V3@1 (3V3), U$1.3V3@2 (3V3), X.1, Y.1, Z.1
+5VN: IC15.16 (VCC), LCD.2, LCD.15, U$1.VIN
+12VN: PVC.1, Q.D, R66.1, R73.1
AD0: IC15.3 (X), U$1.AD0
BAT: BAT.1, C.+, D.A, R.2
D0: IC14.9 (I), IC14.11 (I), U$1.D0
D0-INV: OK8.4 (COL), R73.2, TRX.2
D0-OUT: OK2.4 (COL), Q.G, R66.2, TRX.1
D1: INT.2, U$1.D1
D2: LCD.4, U$1.D2
D3: LCD.6, U$1.D3
D4: U$1.D4
D5: LCD.11, U$1.D5
D6: LCD.12, U$1.D6
D7: LCD.13, U$1.D7
D8: LCD.14, U$1.D8
GNDIO: 4-20MA.2, 5K.1, 100E.1, C75.2, IC18.4 (V-), R94.1, R96.1, VO.3
unnamed: IC17.1 (VCC), R84.1
unnamed: HALL.2, IC17.3 (OUT), R85.1
unnamed: HALL.1, R84.2, R85.2
unnamed: HALL.3, IC17.2 (GND)
unnamed: IC18.1 (OUT), R98.2, R99.1
unnamed: IC18.2 (-IN), R99.2, R101.1
unnamed: LCD.3, R60.1
unnamed: OK2.1 (A), R63.1
unnamed: D.C, L3.1, Q.S
unnamed: OK8.1 (A), R72.1
unnamed: IC14.12 (O), OK2.2 (C)
unnamed: IC14.10 (O), IC14.13 (I)
unnamed: IC14.8 (O), OK8.2 (C)
unnamed: BRIDGE.1, C73.1, IC16.4 (V-), IC16.5 (REF), LOAD.3
unnamed: IC16.6 (OUT), LOAD.2
unnamed: BRIDGE.2, C73.2, IC16.7 (V+), LOAD.1
unnamed: IC16.1 (RG), R93.1
unnamed: IC16.8 (RG), R93.2
unnamed: BRIDGE.4, IC16.2 (-IN)
unnamed: BRIDGE.3, IC16.3 (+IN)
unnamed: IC18.7 (OUT), R94.2, R95.1, VO.2
unnamed: IC18.6 (-IN), R95.2, R98.1
unnamed: IC18.5 (+IN), R96.2, R97.1
unnamed: 5K.2, 5K.3, IC18.3 (+IN), R100.1
unnamed: 4-20MA.1, R101.2, R102.2
unnamed: 100E.2, 100E.3, R102.1
NAGND: BAT.2, C.-, L3.2, OK2.3 (EMIT), OK8.3 (EMIT), PVC.2, R.1, TRX.3
NGND: C70.2, IC14.7 (GND), IC15.6 (INH), IC15.7 (VEE), IC15.8 (GND), INT.3, LCD.1, LCD.5, LCD.16, R60.2, U$1.GND@0 (GND), U$1.GND@1 (GND), U$1.GND@2 (GND), U$1.GND@3 (GND), X.3, Y.3, Z.3
SD0: IC15.11 (A), U$1.SD0
SD1: IC15.10 (B), U$1.SD1
SD2: IC15.9 (C), U$1.SD2
V+: C75.1, IC18.8 (V+), R97.2, R100.2, VO.1
X0: IC15.13 (X0), X.2
X1: IC15.14 (X1), Y.2
X2: IC15.15 (X2), Z.2

Notes on the sheet:
Buck-Boost Converter
Need to take care about drill holes of PCB while routing

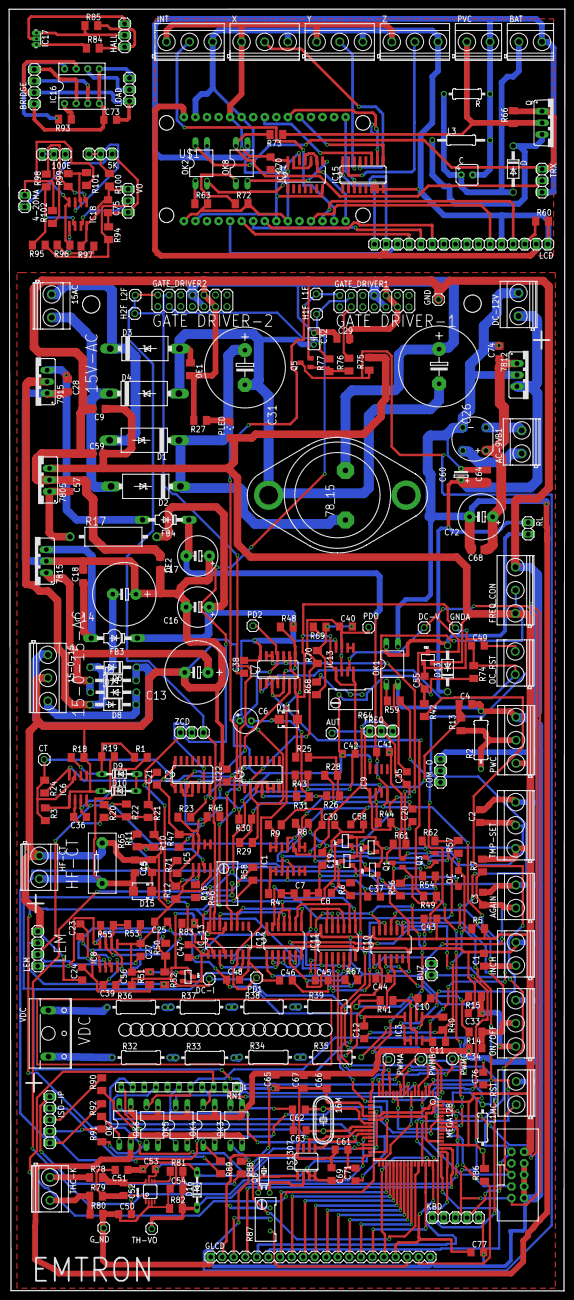
[picture p6: board 2018-SPIT-IH-Ver4-Atmeha-final1.brd from above]

Board: 2 copper layers, 122.2 x 281.8 mm, 314 parts (0 on the bottom side), 231 nets.
