Srijal97/Induction-Heating-ATmega128/CodevisionAVR Project/logo.h

__flash unsigned char arr[1024]={255,255,255,255,255,255,255,255,255,255,255,255,255,255,255,255
, 255,255,255,255,255,255,255,255,255,255,255,127,127,127,63,63
, 63,31,31,31,31,15,15,15,15,15,7,7,7,7,7,7
, 3,3,3,3,3,3,3,3,3,3,3,3,3,3,3,3
, 3,3,3,3,3,3,3,3,3,3,3,3,3,3,3,7
, 7,7,7,7,7,15,15,15,15,31,31,31,31,63,63,63
, 127,127,127,255,255,255,255,255,255,255,255,255,255,255,255,255
, 255,255,255,255,255,255,255,255,255,255,255,255,255,255,255,255
, 255,255,255,255,255,255,255,255,255,255,255,127,127,63,31,31
, 15,7,7,3,3,3,1,1,0,0,0,0,0,0,0,0
, 0,0,0,0,0,192,0,0,0,0,0,0,0,0,0,0
, 0,0,0,0,0,0,0,0,0,0,0,0,0,0,0,0
, 0,0,0,0,0,0,0,0,0,0,0,0,0,0,0,0
, 0,0,0,0,0,0,0,0,0,0,0,0,0,0,0,0
, 0,0,0,0,0,0,1,1,3,3,7,7,15,15,31,63
, 63,127,255,255,255,255,255,255,255,255,255,255,255,255,255,255
, 255,255,255,255,127,31,15,7,3,1,0,0,0,0,0,0
, 0,0,0,0,0,0,0,0,0,0,0,0,0,0,0,0
, 0,0,0,0,0,255,254,128,0,0,0,0,0,0,0,0
, 0,0,0,0,0,0,0,0,0,0,0,240,240,240,32,32
, 32,32,32,32,32,32,32,32,32,32,32,48,120,248,252,252
, 252,252,252,252,252,248,248,112,0,0,0,0,0,0,0,0
, 0,0,0,0,248,248,248,248,248,248,248,248,248,248,248,248
, 248,248,248,249,249,251,255,255,255,255,255,255,255,255,255,255
, 255,255,7,0,0,0,0,0,0,0,0,0,0,0,0,0
, 0,0,0,0,0,0,0,0,0,0,0,0,0,0,0,0
, 0,0,0,0,0,255,255,255,224,0,0,0,0,0,0,0
, 0,0,0,0,0,0,0,0,0,0,0,255,255,255,0,0
, 0,0,0,0,0,0,0,0,0,0,0,0,0,0,0,1
, 1,1,1,1,1,1,0,0,0,0,0,0,0,0,0,0
, 0,0,0,0,248,248,248,248,248,248,248,248,248,248,248,248
, 248,248,248,248,248,248,248,248,248,248,251,255,255,255,255,255
, 255,255,248,192,128,0,0,0,0,0,0,0,0,0,0,0
, 0,0,0,0,0,0,0,0,0,0,0,0,0,0,0,0
, 0,0,0,0,0,127,255,255,255,248,0,0,0,0,0,0
, 0,0,0,0,0,0,0,0,0,0,0,255,255,255,0,0
, 0,0,0,0,0,0,0,0,0,0,0,0,0,0,0,0
, 0,0,0,0,0,0,0,0,0,0,0,0,0,0,0,0
, 0,0,0,0,249,249,249,249,249,249,249,249,249,249,249,249
, 249,249,249,249,249,249,249,249,249,249,249,255,255,255,255,255
, 255,255,255,255,255,254,252,248,240,224,192,128,0,0,0,0
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
