Srijal97/Induction-Heating-ATmega128/(notices)

Notices in the files:
CodevisionAVR Project/glcd.h:
This program is free software: you can redistribute it and/or modify
it under the terms of the GNU Affero General Public License as
published by the Free Software Foundation, either version 3 of the
License.
parts and their libraries:
SparkFun-DiscreteSemi: Licensing: Creative Commons ShareAlike 4.0 International - https://creativecommons.org/licenses/by-sa/4.0
